lab11/CoughNote/hardware/CoughCatcher_v0.2/info.txt

1st filter is for 15kish 
2nd filter is for 30kish
