lab11/CoughNote/nrf51/CoughDetect_v3/test_checklist.txt

Needed:
Null Test
FRAM test
ADC-Test
FRAM-ADC connected test
SD-Card test

Finished:
