lab11/CoughNote/hardware/CoughCatcher_v0.2/todo.txt

Fix comparator footprint 
Add Vref decoupling caps back in
