lab11/CoughNote/hardware/CouchSense_v0/fixes.txt

Fix qfn level shifter pad
fix other level shifter footprint
fix adc footprint / switch adcs
fix silkscreen locations and sizes
fix mic outlines
