lab11/CoughNote/hardware/CouchSense_v0/gerber/coughsense0.pdf

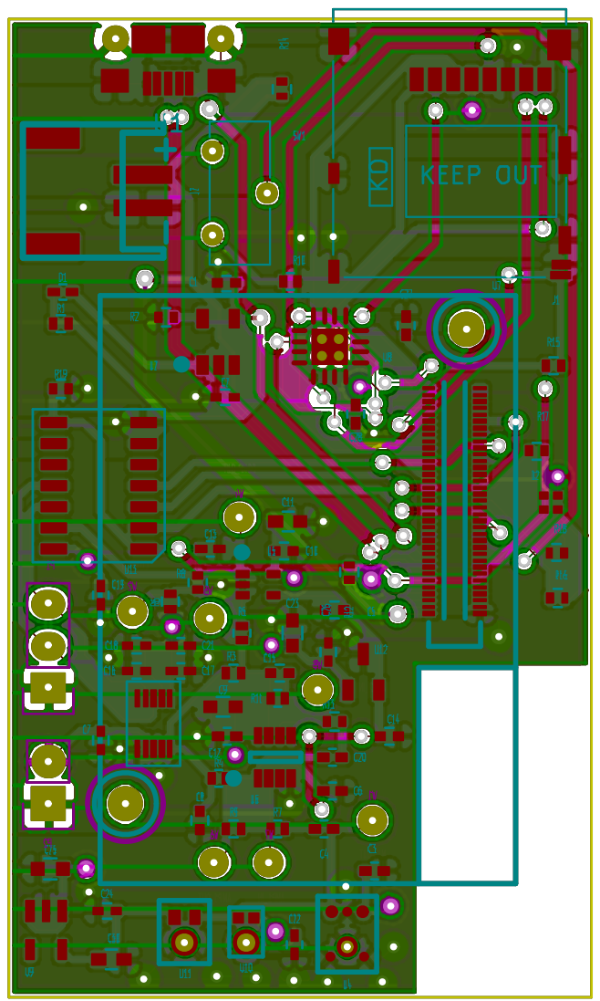
[picture p1: page 1]
