lab11/CoughNote/hardware/CouchSense_v0/coughsense.kicad_pcb

## KiCad design hardware/CouchSense_v0/coughsense.kicad_pcb (2016-07-29, an earlier design)

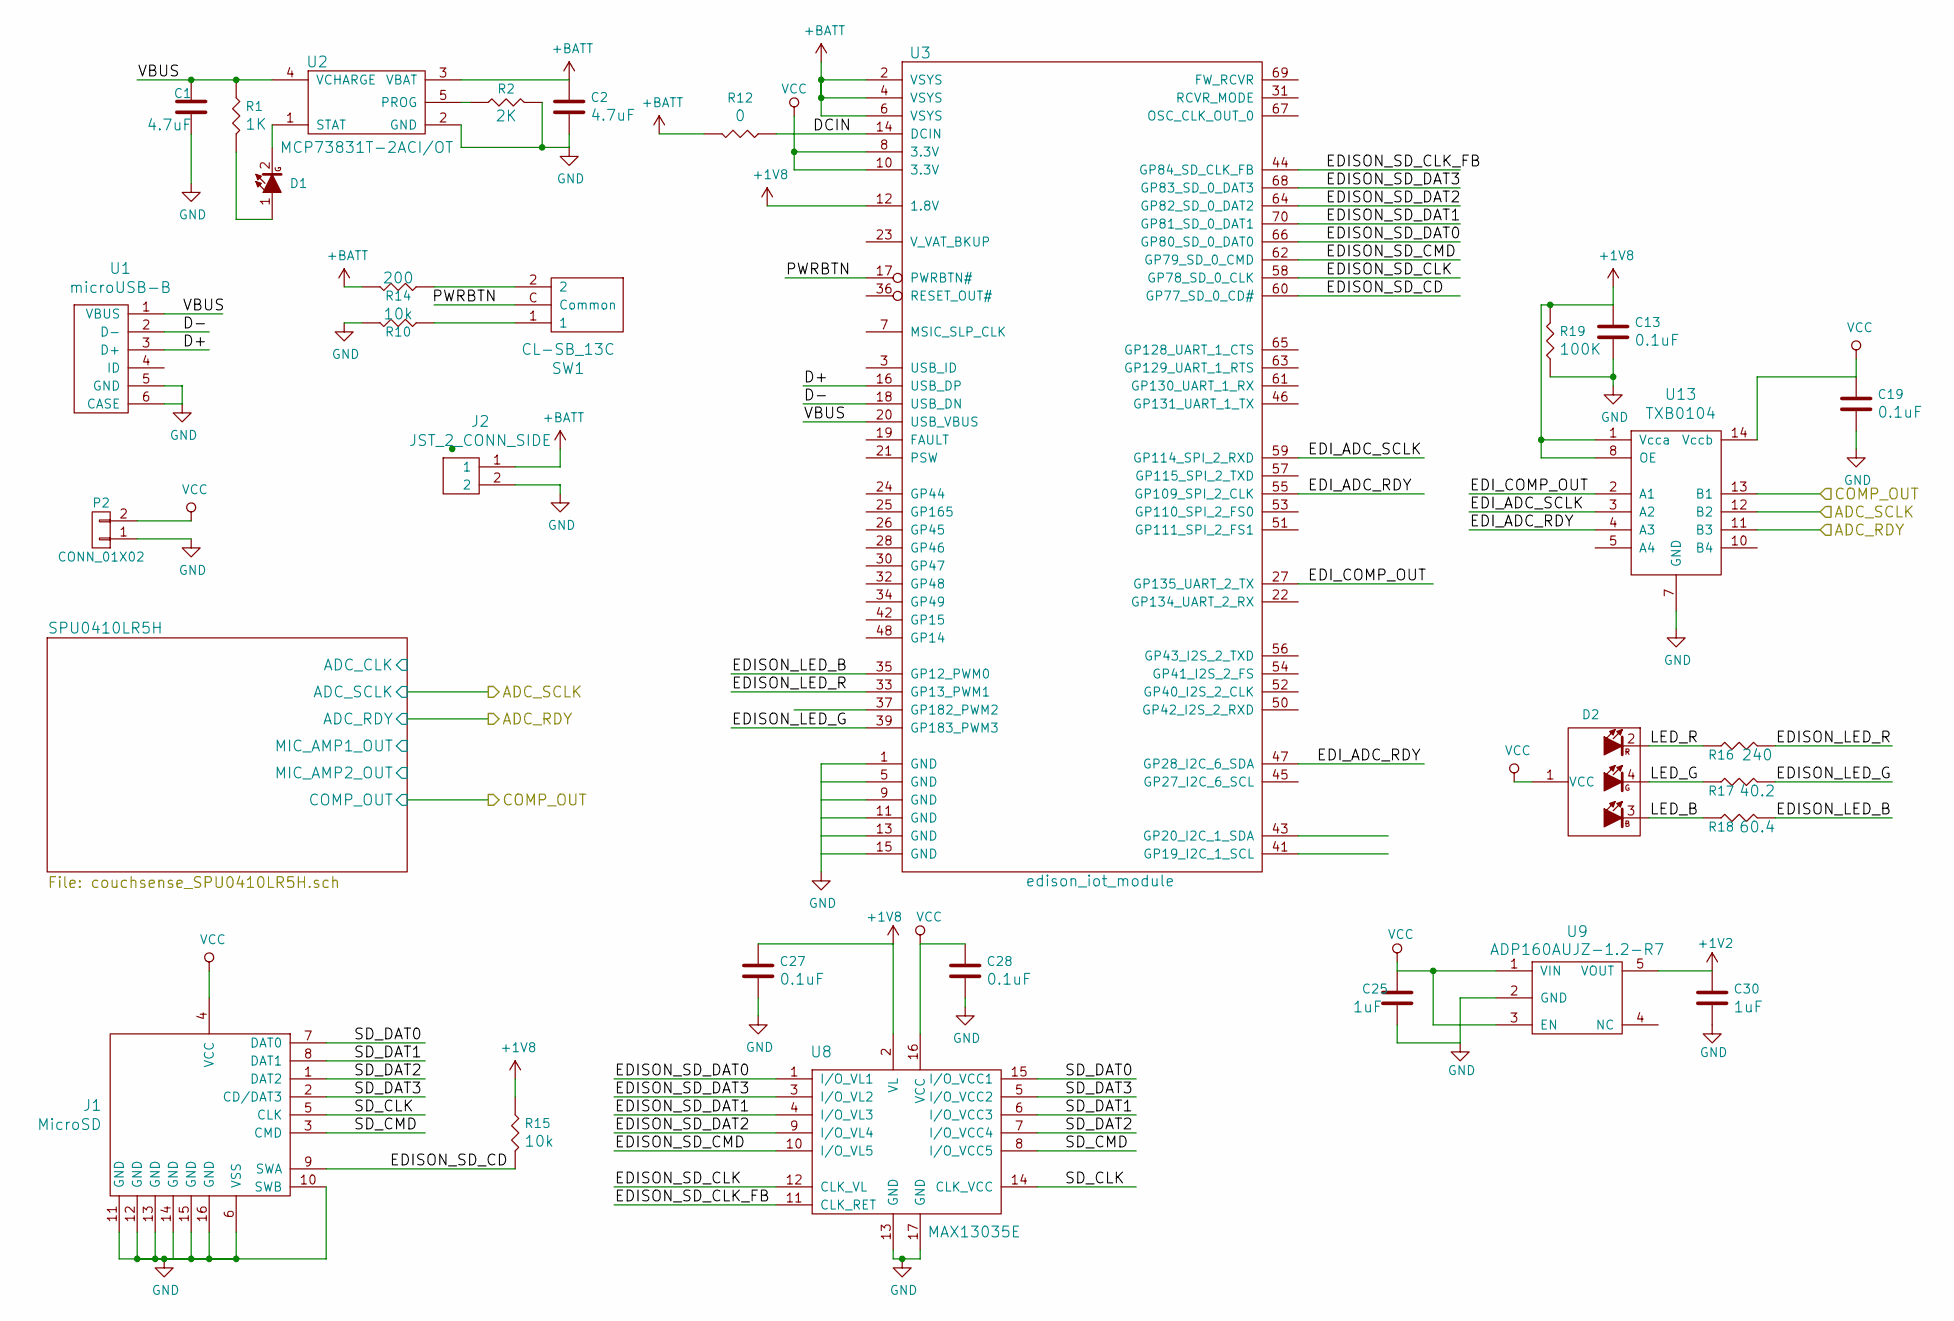
[picture p2: schematic coughsense.sch]

Parts:
C1, C2: C_4.7u_0402_10V_10%_X5R; C_0402
C13, C19, C27, C28: C_0.1u_0402_10V_10%_JB; C_0402
C25, C30: C_1u_0402_10V_10%_JB; C_0603
D1: LED_GREEN_0402_20mA; C_0402
D2: LED_RGB_0404_10mA; 0404
J1: MicroSD; 2201778-1
J2: JST_2_CONN_SIDE; CONN_JST-2_SMD_SIDE
P2: CONN_01X02; Pin_Header_Straight_1x02
R1: R_1K_0402_1%,100ppm/c,0.2W; R_0402
R2: R_2K_0402_1%,100ppm/c,0.1W; R_0402
R10, R15: R_10k_0402_1%,100ppm/c,0.063W; R_0402
R12: R_0_0402_.1W; R_0402
R14: R_200_0402_1%,100ppm/c,0.1W; R_0402
R16: R_240_0402_1%,100ppm/c,0.063W; R_0402
R17: R_40.2_0402_1%,100ppm/c,0.063W; R_0402
R18: R_60.4_0402_1%,100ppm/c,0.1W; R_0402
R19: R_100K_0402_0.5%,25ppm/c,0.063W; R_0402
SW1: CL-SB_13C; CL-SB-12C
U1: microUSB-B; MICRO_USB_RECEPTABLE
U2: MCP73831T-2ACI/OT; SOT-23-5
U3: edison_iot_module; intel_edison_compute_module
U8: MAX13035E; TQFN-16-4x4mm
U9: ADP160AUJZ-1.2-R7; TSOT-5
U13: TXB0104; SOIC-14

Connections:
+1V2: C30.1, U9.5 (VOUT); also elsewhere on the board
+1V8: C13.1, C27.1, R15.1, R19.2 (R1), U3.12 (1.8V), U8.2 (VL), U13.1 (Vcca), U13.8 (OE)
+BATT: C2.1, J2.1, R12.2 (R1), R14.2 (R1), U2.3 (VBAT), U3.2 (VSYS), U3.4 (VSYS), U3.6 (VSYS)
/ADC_RDY: U13.11 (B3); also elsewhere on the board
/ADC_SCLK: U13.12 (B2); also elsewhere on the board
/COMP_OUT: U13.13 (B1); also elsewhere on the board
/D+: U1.3 (D+), U3.16 (USB_DP)
/D-: U1.2 (D-), U3.18 (USB_DN)
/DCIN: R12.1, U3.14 (DCIN)
/EDISON_LED_B: R18.2 (R1), U3.35 (GP12_PWM0)
/EDISON_LED_G: R17.2 (R1), U3.39 (GP183_PWM3)
/EDISON_LED_R: R16.2 (R1), U3.33 (GP13_PWM1)
/EDISON_SD_CD: J1.9 (SWA), R15.2 (R1), U3.60 (GP77_SD_0_CD#)
/EDISON_SD_CLK: U3.58 (GP78_SD_0_CLK), U8.12 (CLK_VL)
/EDISON_SD_CLK_FB: U3.44 (GP84_SD_CLK_FB), U8.11 (CLK_RET)
/EDISON_SD_CMD: U3.62 (GP79_SD_0_CMD), U8.10 (I/O_VL5)
/EDISON_SD_DAT0: U3.66 (GP80_SD_0_DAT0), U8.1 (I/O_VL1)
/EDISON_SD_DAT1: U3.70 (GP81_SD_0_DAT1), U8.4 (I/O_VL3)
/EDISON_SD_DAT2: U3.64 (GP82_SD_0_DAT2), U8.9 (I/O_VL4)
/EDISON_SD_DAT3: U3.68 (GP83_SD_0_DAT3), U8.3 (I/O_VL2)
/EDI_ADC_RDY: U3.47 (GP28_I2C_6_SDA), U3.55 (GP109_SPI_2_CLK), U13.4 (A3)
/EDI_ADC_SCLK: U3.59 (GP114_SPI_2_RXD), U13.3 (A2)
/EDI_COMP_OUT: U3.27 (GP135_UART_2_TX), U13.2 (A1)
/LED_B: D2.3, R18.1
/LED_G: D2.4, R17.1
/LED_R: D2.2, R16.1
/PWRBTN: SW1.C (Common), U3.17 (PWRBTN#)
/SD_CLK: J1.5 (CLK), U8.14 (CLK_VCC)
/SD_CMD: J1.3 (CMD), U8.8 (I/O_VCC5)
/SD_DAT0: J1.7 (DAT0), U8.15 (I/O_VCC1)
/SD_DAT1: J1.8 (DAT1), U8.6 (I/O_VCC3)
/SD_DAT2: J1.1 (DAT2), U8.7 (I/O_VCC4)
/SD_DAT3: J1.2 (CD/DAT3), U8.5 (I/O_VCC2)
/VBUS: C1.1, R1.1, U1.1 (VBUS), U2.4 (VCHARGE), U3.20 (USB_VBUS)
GND: C1.2, C2.2, C13.2, C19.2, C25.2, C27.2, C28.2, C30.2, J1.6 (VSS), J1.10 (SWB), J1.11 (GND), J1.12 (GND), J1.13 (GND), J1.14 (GND), J1.15 (GND), J1.16 (GND), J2.2, P2.1, R2.2 (R1), R10.2 (R1), R19.1, U1.5 (GND), U1.6 (CASE), U2.2 (GND), U3.1 (GND), U8.13 (GND), U8.17 (GND), U9.2 (GND), U13.7 (GND); also elsewhere on the board
unnamed: D1.1, R1.2 (R1)
unnamed: D1.2, U2.1 (STAT)
unnamed: R2.1, U2.5 (PROG)
unnamed: R10.1, SW1.1
unnamed: R14.1, SW1.2
VCC: C19.1, C25.1, C28.1, D2.1 (VCC), J1.4 (VCC), P2.2, U3.8 (3.3V), U3.10 (3.3V), U8.16 (VCC), U9.1 (VIN), U9.3 (EN), U13.14 (Vccb); also elsewhere on the board

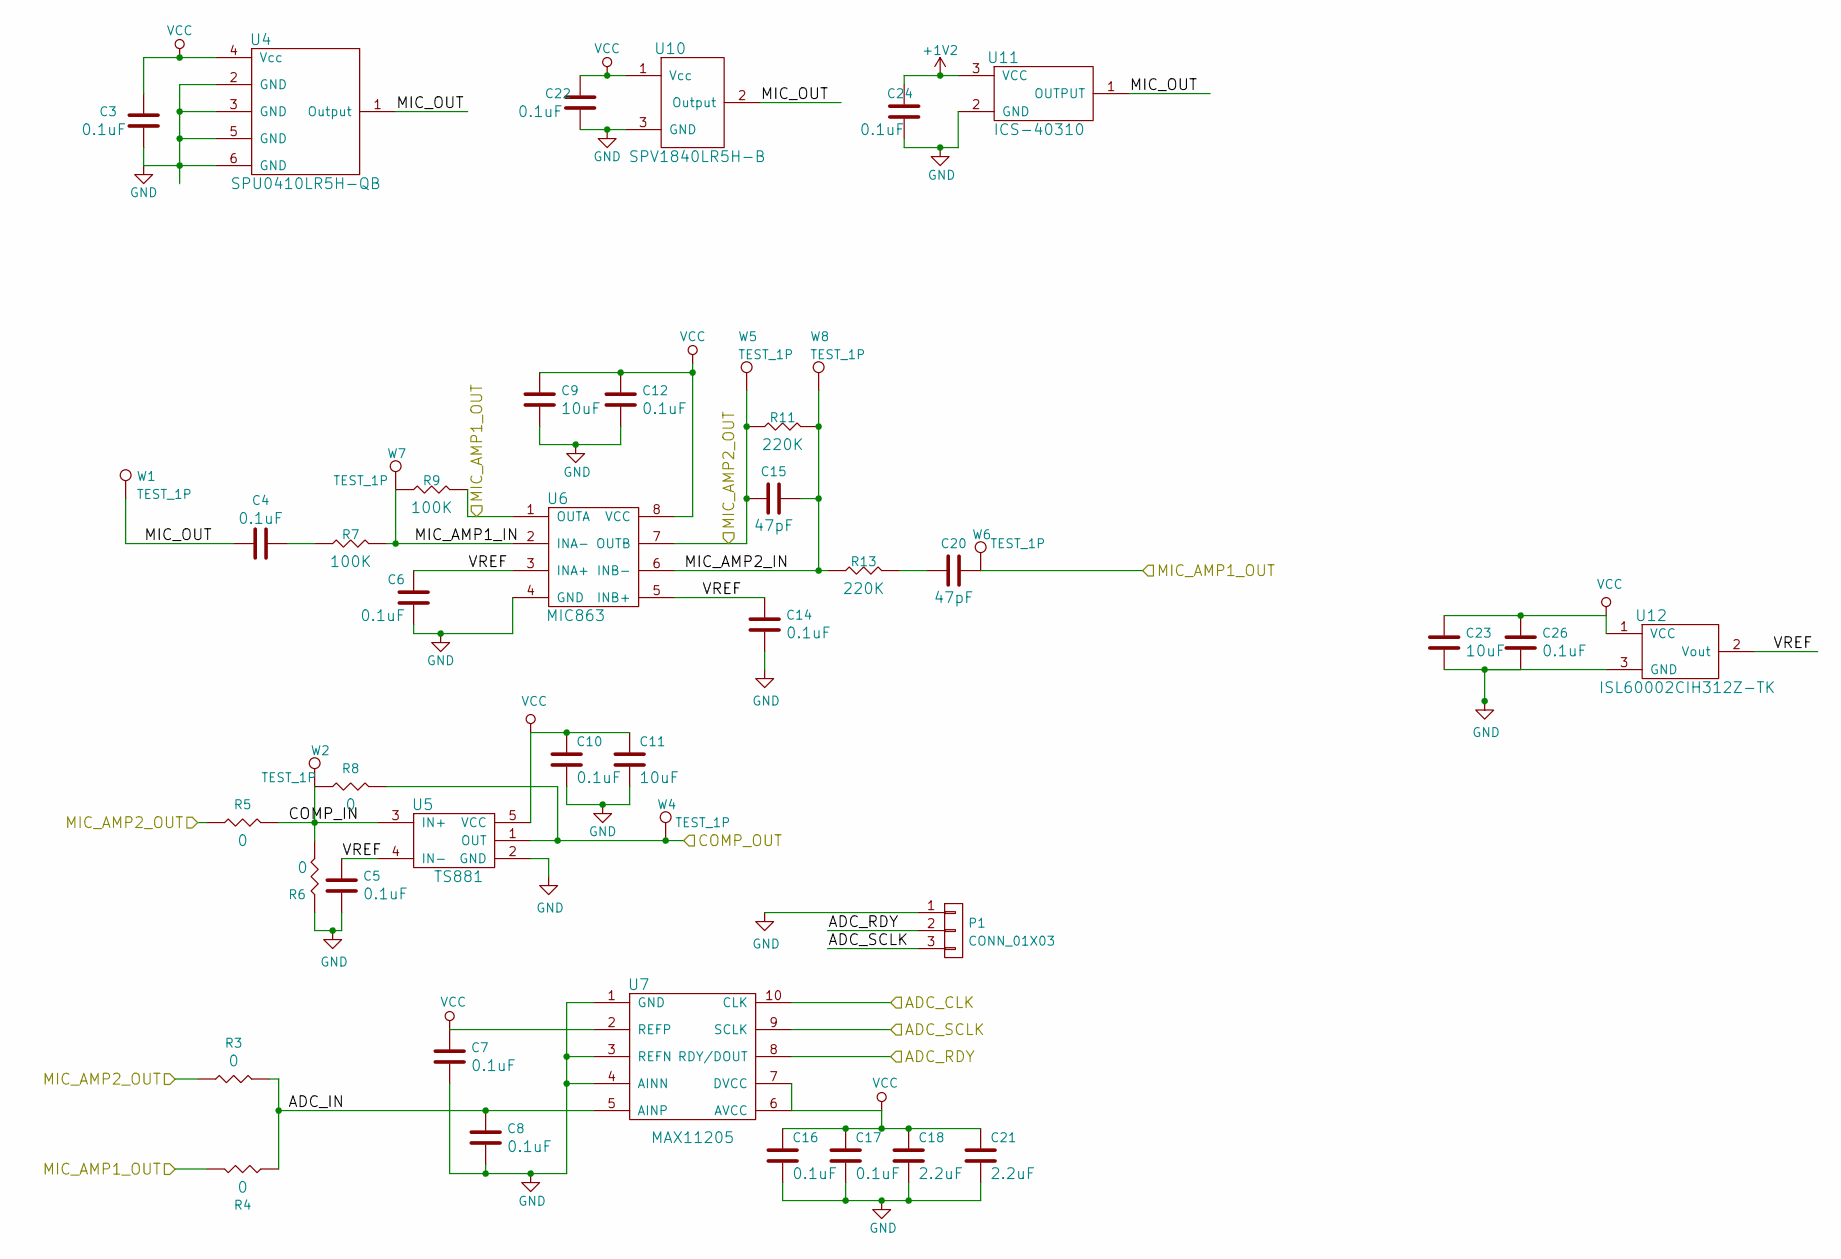
[picture p3: schematic couchsense_SPU0410LR5H.sch]

Parts:
C3, C4, C5, C6, C7, C8, C10, C12, C14, C16, C17, C22, C24, C26: C_0.1u_0402_10V_10%_JB; C_0402
C9, C11, C23: C_10u_0603_10V_10%_JB; C_0603
C15, C20: C_47p_0402_1%_C0G,NP0; C_0402
C18, C21: C_2.2u_0402_10V_10%_JB; C_0402
P1: CONN_01X03; Pin_Header_Straight_1x03
R3, R4, R5, R6, R8: R_0_0402_.1W; R_0402
R7, R9: R_100K_0402_0.5%,25ppm/c,0.063W; R_0402
R11, R13: R_220K_0402_1%,100ppm/c,0.063W; R_0402
U4: SPU0410LR5H-QB
U5: TS881; SC-70-5
U6: MIC863; SOT-23-8
U7: MAX11205; uSOP-10
U10: SPV1840LR5H-B
U11: ICS-40310
U12: ISL60002CIH312Z-TK; ISL60002
W1, W2, W4, W5, W6, W7, W8: TEST_1P; Testpoint

Connections:
+1V2: C24.1, U11.3 (VCC); also elsewhere on the board
/ADC_RDY: P1.2, U7.8 (RDY/DOUT); also elsewhere on the board
/ADC_SCLK: P1.3, U7.9 (SCLK); also elsewhere on the board
/COMP_OUT: R8.2 (R1), U5.1 (OUT), W4.1; also elsewhere on the board
/SPU0410LR5H/ADC_CLK: U7.10 (CLK)
/SPU0410LR5H/ADC_IN: C8.1, R3.2 (R1), R4.1, U7.5 (AINP)
/SPU0410LR5H/COMP_IN: R5.2 (R1), R6.1, R8.1, U5.3 (IN+), W2.1
/SPU0410LR5H/MIC_AMP1_IN: R7.2 (R1), R9.1, U6.2 (INA-), W7.1
/SPU0410LR5H/MIC_AMP1_OUT: C20.1, R4.2 (R1), R9.2 (R1), U6.1 (OUTA), W6.1
/SPU0410LR5H/MIC_AMP2_IN: C15.1, R11.2 (R1), R13.1, U6.6 (INB-), W8.1
/SPU0410LR5H/MIC_AMP2_OUT: C15.2, R3.1, R5.1, R11.1, U6.7 (OUTB), W5.1
/SPU0410LR5H/MIC_OUT: C4.2, U4.1 (Output), U10.2 (Output), U11.1 (OUTPUT), W1.1
/SPU0410LR5H/VREF: C5.1, C6.1, C14.1, U5.4 (IN-), U6.3 (INA+), U6.5 (INB+), U12.2 (Vout)
GND: C3.1, C5.2, C6.2, C7.2, C8.2, C9.2, C10.2, C11.2, C12.2, C14.2, C16.2, C17.2, C18.2, C21.2, C22.2, C23.2, C24.2, C26.2, P1.1, R6.2 (R1), U4.2 (GND), U4.3 (GND), U4.5 (GND), U4.6 (GND), U5.2 (GND), U6.4 (GND), U7.1 (GND), U7.3 (REFN), U7.4 (AINN), U10.3 (GND), U11.2 (GND), U12.3 (GND); also elsewhere on the board
unnamed: C4.1, R7.1
unnamed: C20.2, R13.2 (R1)
VCC: C3.2, C7.1, C9.1, C10.1, C11.1, C12.1, C16.1, C17.1, C18.1, C21.1, C22.1, C23.1, C26.1, U4.4 (Vcc), U5.5 (VCC), U6.8 (VCC), U7.2 (REFP), U7.6 (AVCC), U7.7 (DVCC), U10.1 (Vcc), U12.1 (VCC); also elsewhere on the board

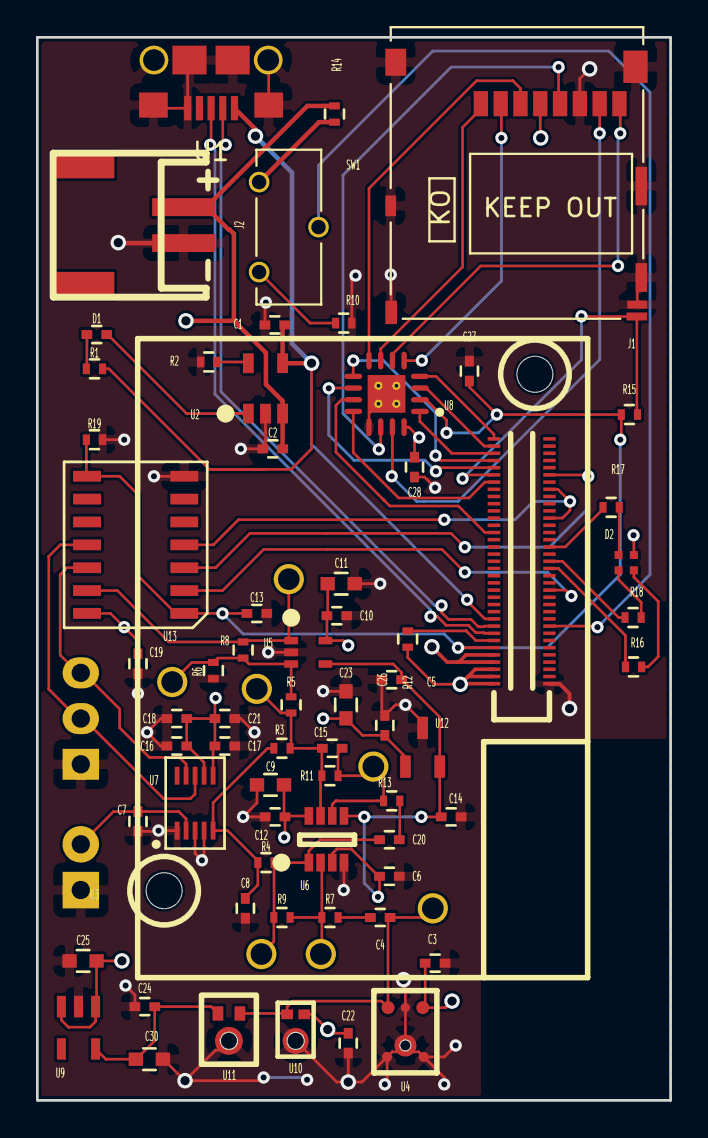
[picture p4: board coughsense.kicad_pcb from above]

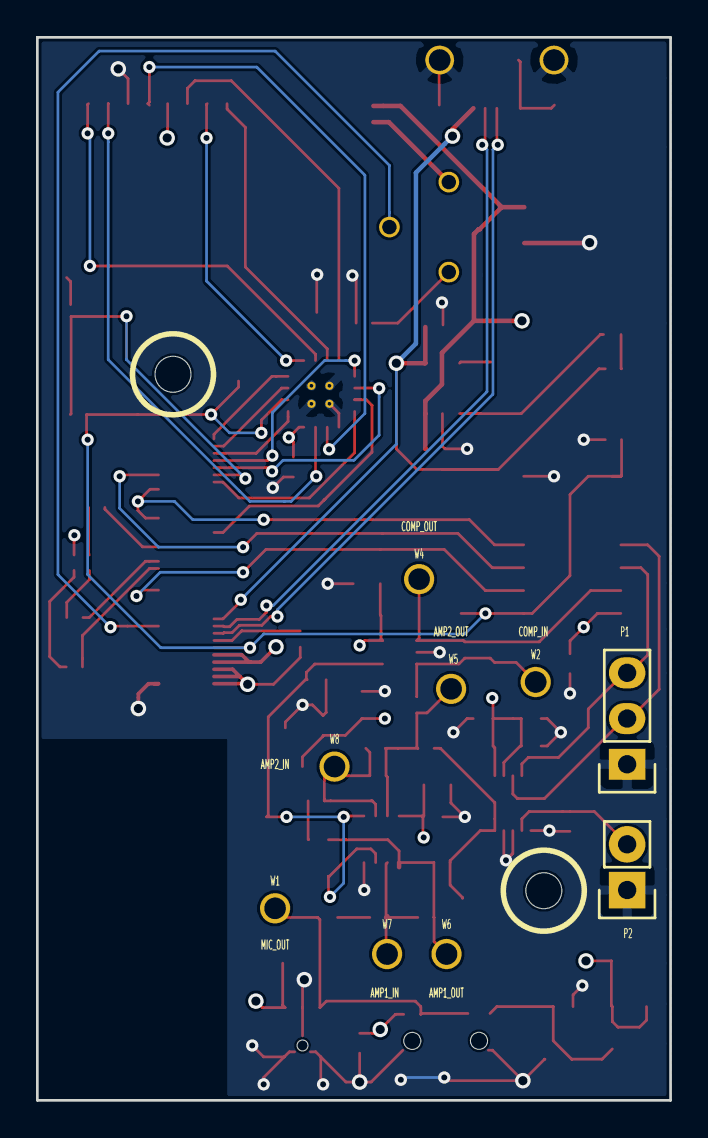
[picture p5: board coughsense.kicad_pcb from below]

Board: 4 copper layers, 35.2 x 59.1 mm, 75 parts (8 on the bottom side), 51 nets.
