lab11/CoughNote/hardware/CoughCatcher_v0.2/coughcatcher_v0.kicad_pcb

## KiCad design hardware/CoughCatcher_v0.2/coughcatcher_v0.kicad_pcb (2016-07-29)

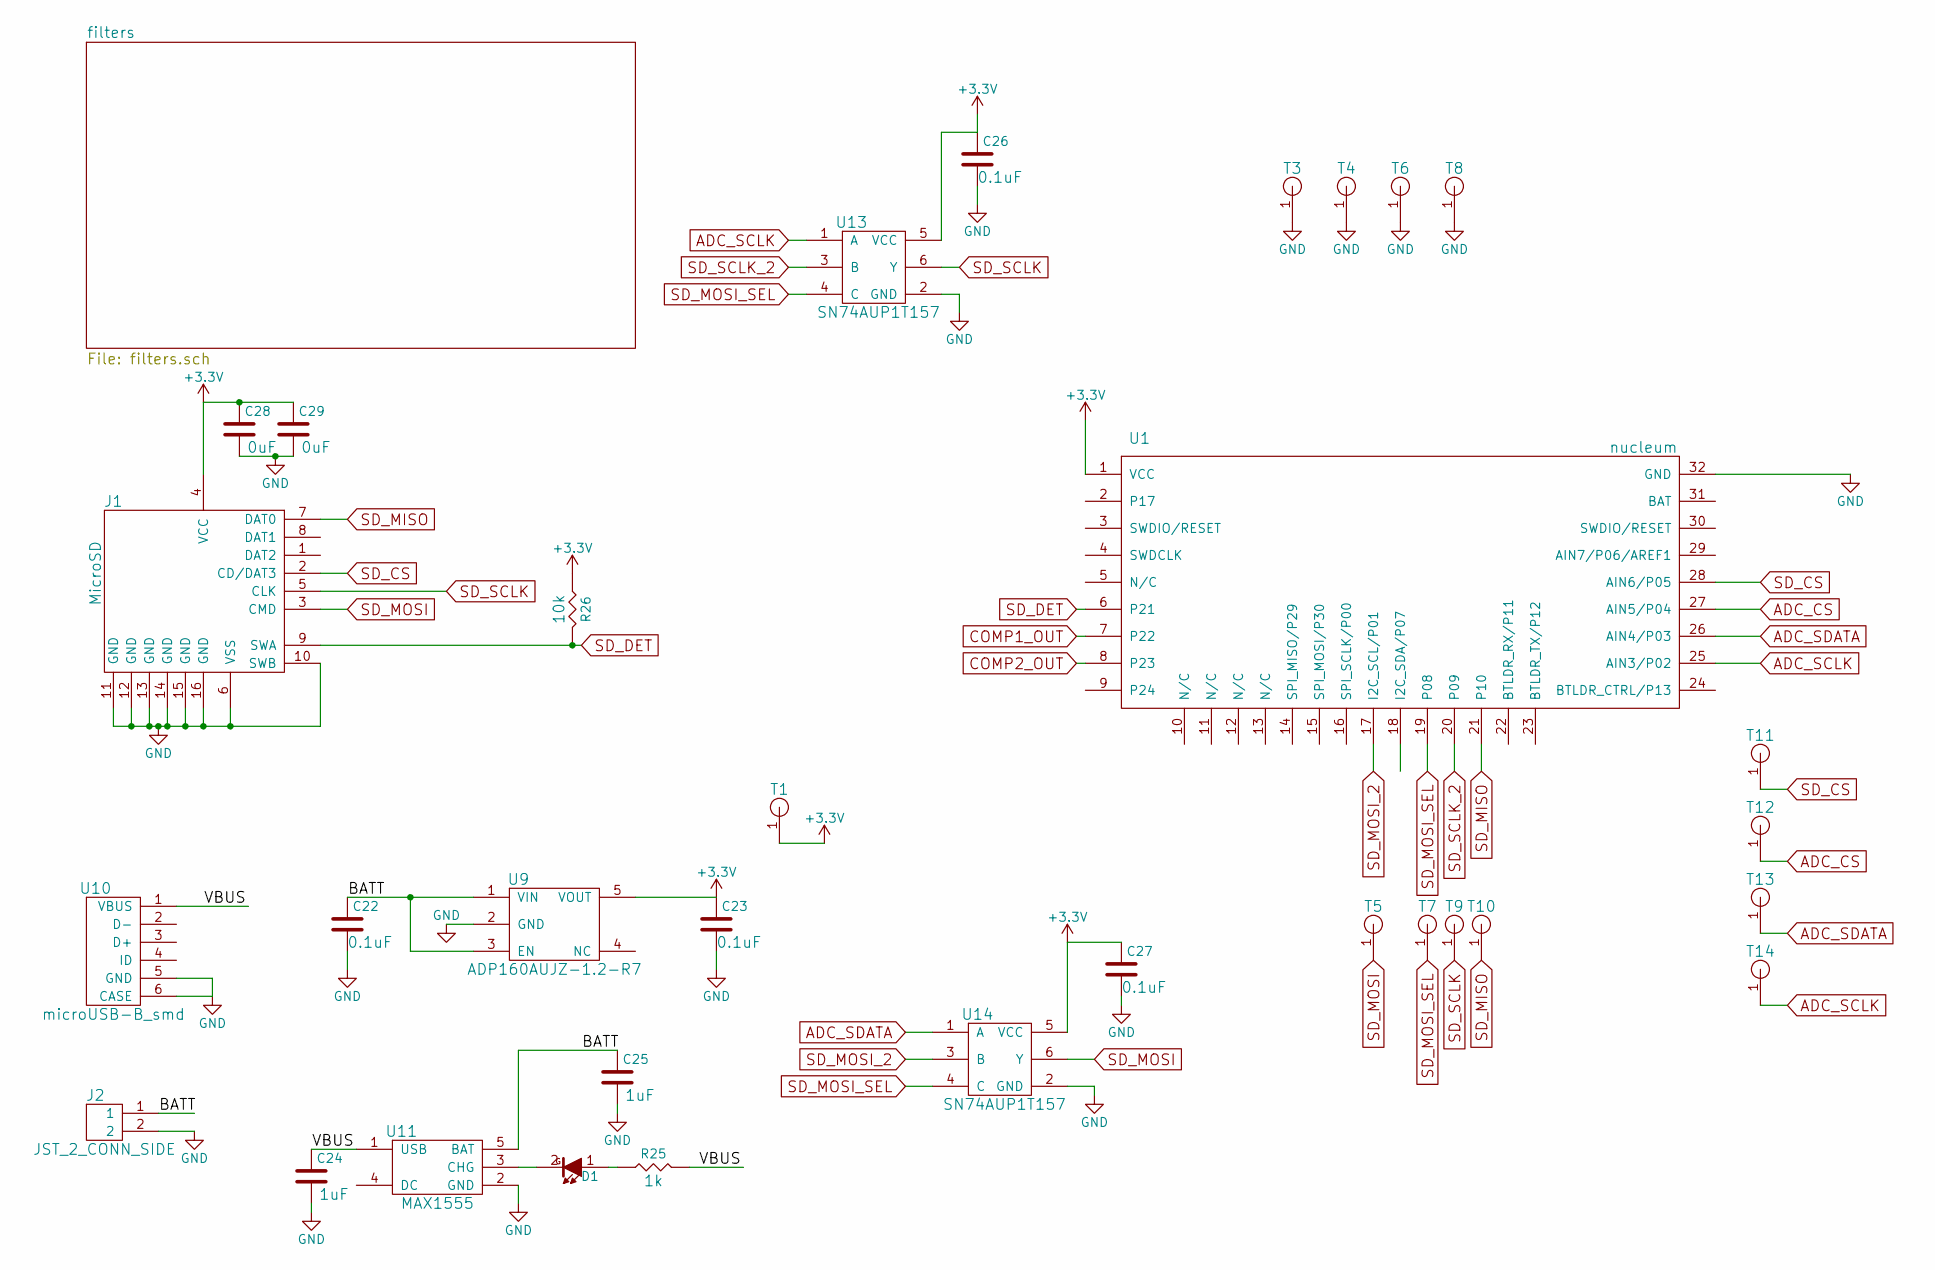
[picture p6: schematic coughcatcher_v0.sch]

Parts:
C22, C23, C26, C27: C_0.1u_0402_10V_10%_JB; C_0402
C24, C25: C_1u_0402_10V_10%_JB; C_0402
C28, C29: GENERIC_C_0402; C_0402
D1: LED_GREEN_0402_20mA; C_0402
J1: MicroSD; 2201778-1
J2: JST_2_CONN_SIDE; CONN_JST-2_SMD_SIDE
R25, R26: GENERIC_R_0402; R_0402
T1, T3, T4, T5, T6, T7, T8, T9, T10, T11, T12, T13, T14: PROBEPAD_0805
U1: nucleum; NUCLEUM
U9: ADP160AUJZ-1.2-R7; TSOT-5
U10: microUSB-B_smd; USB_MICRO_B-HIROSE-ZX62R-B-5P
U11: MAX1555; SOT-23-5
U13, U14: SN74AUP1T157; SC-70-6

Connections:
+3V3: C23.1, C26.1, C27.1, C28.1, C29.1, J1.4 (VCC), R26.1, T1.1, U1.1 (VCC), U9.5 (VOUT), U13.5 (VCC), U14.5 (VCC); also elsewhere on the board
/BATT: C22.1, C25.1, J2.1, U9.1 (VIN), U9.3 (EN), U11.5 (BAT)
/VBUS: C24.1, R25.2 (R1), U10.1 (VBUS), U11.1 (USB)
ADC_CS: T12.1, U1.27 (AIN5/P04); also elsewhere on the board
ADC_SCLK: T14.1, U1.25 (AIN3/P02), U13.1 (A); also elsewhere on the board
ADC_SDATA: T13.1, U1.26 (AIN4/P03), U14.1 (A); also elsewhere on the board
COMP1_OUT: U1.7 (P22); also elsewhere on the board
COMP2_OUT: U1.8 (P23); also elsewhere on the board
GND: C22.2, C23.2, C24.2, C25.2, C26.2, C27.2, C28.2, C29.2, J1.6 (VSS), J1.10 (SWB), J1.11 (GND), J1.12 (GND), J1.13 (GND), J1.14 (GND), J1.15 (GND), J1.16 (GND), J2.2, T3.1, T4.1, T6.1, T8.1, U1.32 (GND), U9.2 (GND), U10.5 (GND), U10.6 (CASE), U11.2 (GND), U13.2 (GND), U14.2 (GND); also elsewhere on the board
unnamed: D1.1, R25.1
unnamed: D1.2, U11.3 (CHG)
SD_CS: J1.2 (CD/DAT3), T11.1, U1.28 (AIN6/P05)
SD_DET: J1.9 (SWA), R26.2 (R1), U1.6 (P21)
SD_MISO: J1.7 (DAT0), T10.1, U1.21 (P10)
SD_MOSI: J1.3 (CMD), T5.1, U14.6 (Y)
SD_MOSI_2: U1.17 (I2C_SCL/P01), U14.3 (B)
SD_MOSI_SEL: T7.1, U1.19 (P08), U13.4 (C), U14.4 (C)
SD_SCLK: J1.5 (CLK), T9.1, U13.6 (Y)
SD_SCLK_2: U1.20 (P09), U13.3 (B)

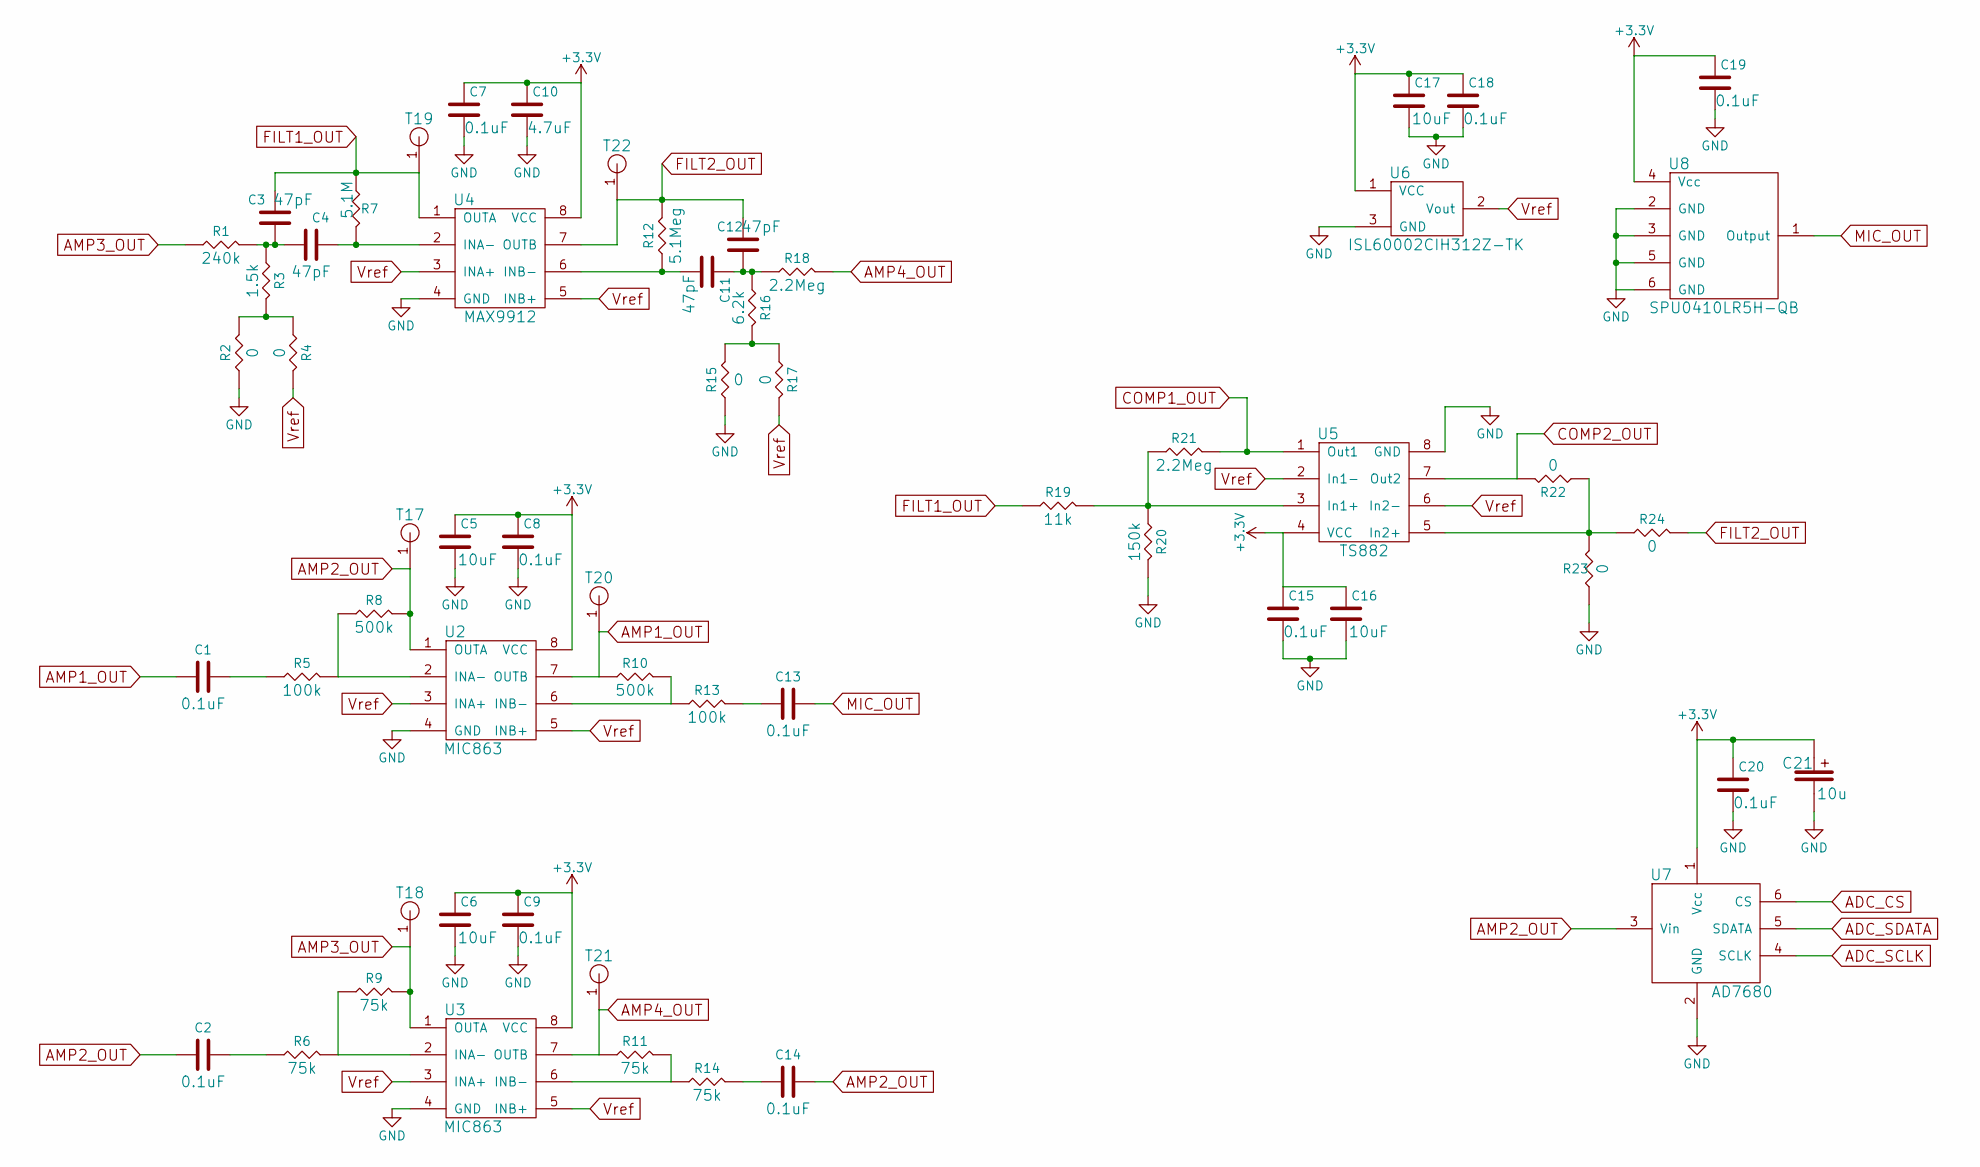
[picture p7: schematic filters.sch]

Parts:
C1, C2, C7, C8, C9, C13, C14, C15, C18, C19, C20: C_0.1u_0402_10V_10%_JB; C_0402
C3, C4, C11, C12: GENERIC_C_0402; C_0402
C5, C6, C16, C17: C_10u_0603_10V_10%_JB; C_0603
C10: C_4.7u_0402_10V_10%_X5R; C_0402
C21: C_10u_0603_10V_tantalum; C_0603
R1, R2, R3, R4, R5, R6, R7, R8, R9, R10, R11, R12, R13, R14, R15, R16, R17, R18, R19, R20, R21, R22, R23, R24: GENERIC_R_0402; R_0402
T17, T18, T19, T20, T21, T22: PROBEPAD_0805
U2, U3: MIC863; SOT-23-8
U4: MAX9912; SOT-23-8
U5: TS882; MSOP-8_3x3mm_Pitch0.65mm
U6: ISL60002CIH312Z-TK; ISL60002
U7: AD7680; SOT-23-6
U8: SPU0410LR5H-QB

Connections:
+3V3: C5.1, C6.1, C7.1, C8.1, C9.1, C10.1, C15.1, C16.1, C17.1, C18.1, C19.1, C20.1, C21.1, U2.8 (VCC), U3.8 (VCC), U4.8 (VCC), U5.4 (VCC), U6.1 (VCC), U7.1 (Vcc), U8.4 (Vcc); also elsewhere on the board
ADC_CS: U7.6 (CS); also elsewhere on the board
ADC_SCLK: U7.4 (SCLK); also elsewhere on the board
ADC_SDATA: U7.5 (SDATA); also elsewhere on the board
AMP1_OUT: C1.2, R10.1, T20.1, U2.7 (OUTB)
AMP2_OUT: C2.2, C14.1, R8.2 (R1), T17.1, U2.1 (OUTA), U7.3 (Vin)
AMP3_OUT: R1.1, R9.2 (R1), T18.1, U3.1 (OUTA)
AMP4_OUT: R11.1, R18.2 (R1), T21.1, U3.7 (OUTB)
COMP1_OUT: R21.2 (R1), U5.1 (Out1); also elsewhere on the board
COMP2_OUT: R22.1, U5.7 (Out2); also elsewhere on the board
FILT1_OUT: C3.2, R7.1, R19.1, T19.1, U4.1 (OUTA)
FILT2_OUT: C12.1, R12.2 (R1), R24.2 (R1), T22.1, U4.7 (OUTB)
GND: C5.2, C6.2, C7.2, C8.2, C9.2, C10.2, C15.2, C16.2, C17.2, C18.2, C19.2, C20.2, C21.2, R2.1, R15.1, R20.2 (R1), R23.1, U2.4 (GND), U3.4 (GND), U4.4 (GND), U5.8 (GND), U6.3 (GND), U7.2 (GND), U8.2 (GND), U8.3 (GND), U8.5 (GND), U8.6 (GND); also elsewhere on the board
MIC_OUT: C13.1, U8.1 (Output)
unnamed: C1.1, R5.1
unnamed: C2.1, R6.1
unnamed: C3.1, C4.2, R1.2 (R1), R3.1
unnamed: C4.1, R7.2 (R1), U4.2 (INA-)
unnamed: C11.1, C12.2, R16.1, R18.1
unnamed: C11.2, R12.1, U4.6 (INB-)
unnamed: C13.2, R13.2 (R1)
unnamed: C14.2, R14.2 (R1)
unnamed: R2.2 (R1), R3.2 (R1), R4.1
unnamed: R5.2 (R1), R8.1, U2.2 (INA-)
unnamed: R6.2 (R1), R9.1, U3.2 (INA-)
unnamed: R10.2 (R1), R13.1, U2.6 (INB-)
unnamed: R11.2 (R1), R14.1, U3.6 (INB-)
unnamed: R15.2 (R1), R16.2 (R1), R17.1
unnamed: R19.2 (R1), R20.1, R21.1, U5.3 (In1+)
unnamed: R22.2 (R1), R23.2 (R1), R24.1, U5.5 (In2+)
Vref: R4.2 (R1), R17.2 (R1), U2.3 (INA+), U2.5 (INB+), U3.3 (INA+), U3.5 (INB+), U4.3 (INA+), U4.5 (INB+), U5.2 (In1-), U5.6 (In2-), U6.2 (Vout)

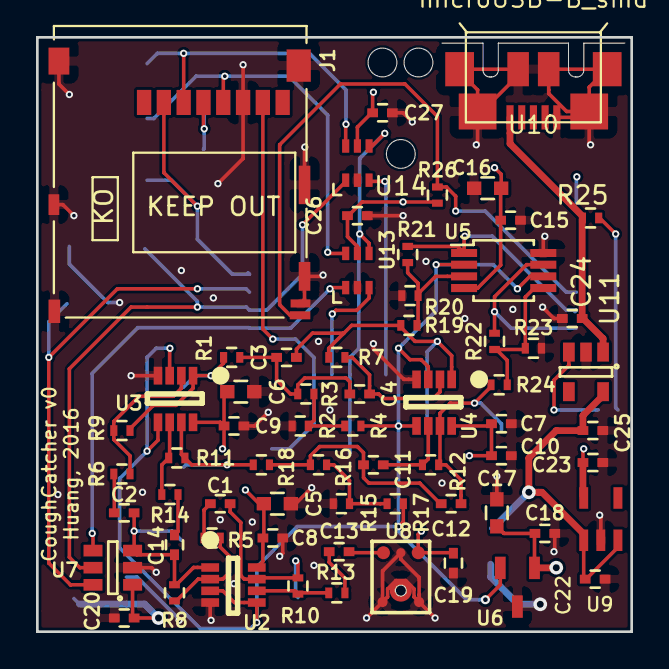
[picture p8: board coughcatcher_v0.kicad_pcb from above]

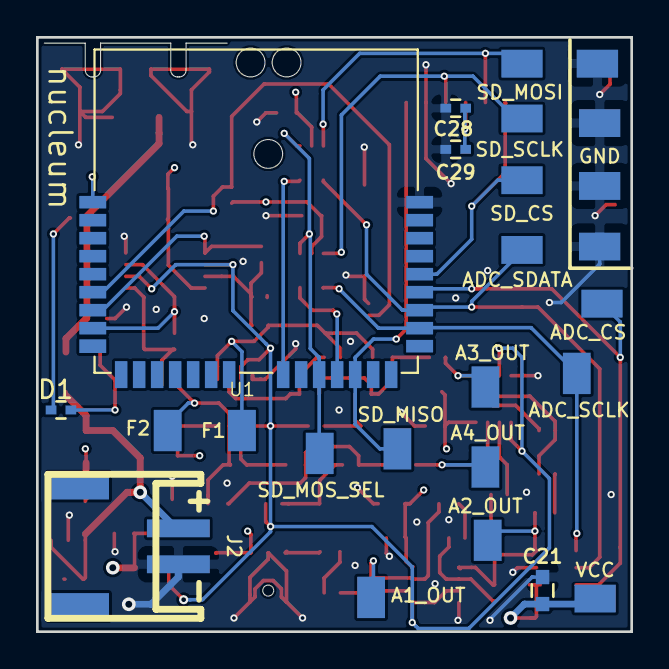
[picture p9: board coughcatcher_v0.kicad_pcb from below]

Board: 4 copper layers, 33.0 x 33.0 mm, 90 parts (25 on the bottom side), 43 nets.
