lab11/CoughNote/(commit log)

2016-07-29 hardware files
    [couchsense_SPU0410LR5H.sch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]
2017-01-27 platforms for CoughDetect boards
2017-01-30 added spi configs to platform files
2017-03-31 fixed get_unixtime not updating seconds
    [rv3049.c]
2017-04-06 app to store unproccessed adc readings to flash
2017-07-25 fixed timer not being initialized
    [main.c]
